YCF/FC660C-Alt-Controller/652F30B80E1377E0EDB15F7A12F2B2C8.png

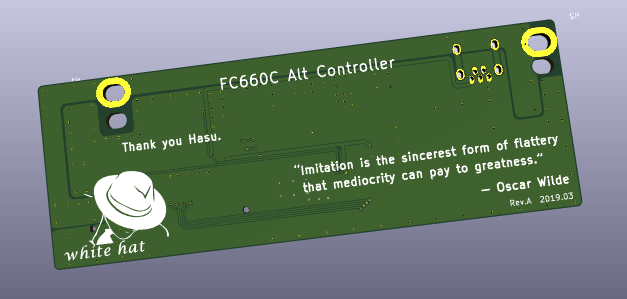
652F30B80E1377E0EDB15F7A12F2B2C8.png
