YCF/FC660C-Alt-Controller/F120661238BAEC37F7B5C9E4A22C532F.png

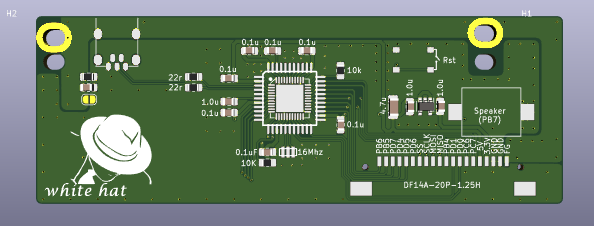
F120661238BAEC37F7B5C9E4A22C532F.png
