YCF/FC660C-Alt-Controller/dxf/edge.dxf

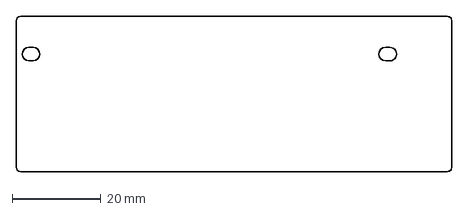
[picture p3: CAD file, 2019-03-09]
dxf/edge.dxf
98.3 x 35.0 mm
