YCF/FC660C-Alt-Controller/dxf/dwg.dxf

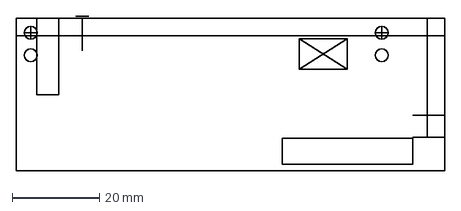
[picture p4: CAD file, 2019-03-09]
dxf/dwg.dxf
98.3 x 35.5 mm
