YCF/FC660C-Alt-Controller/kicad/fc660c/fc660c.kicad_pcb

## KiCad design kicad/fc660c/fc660c.kicad_pcb (2019-03-09)

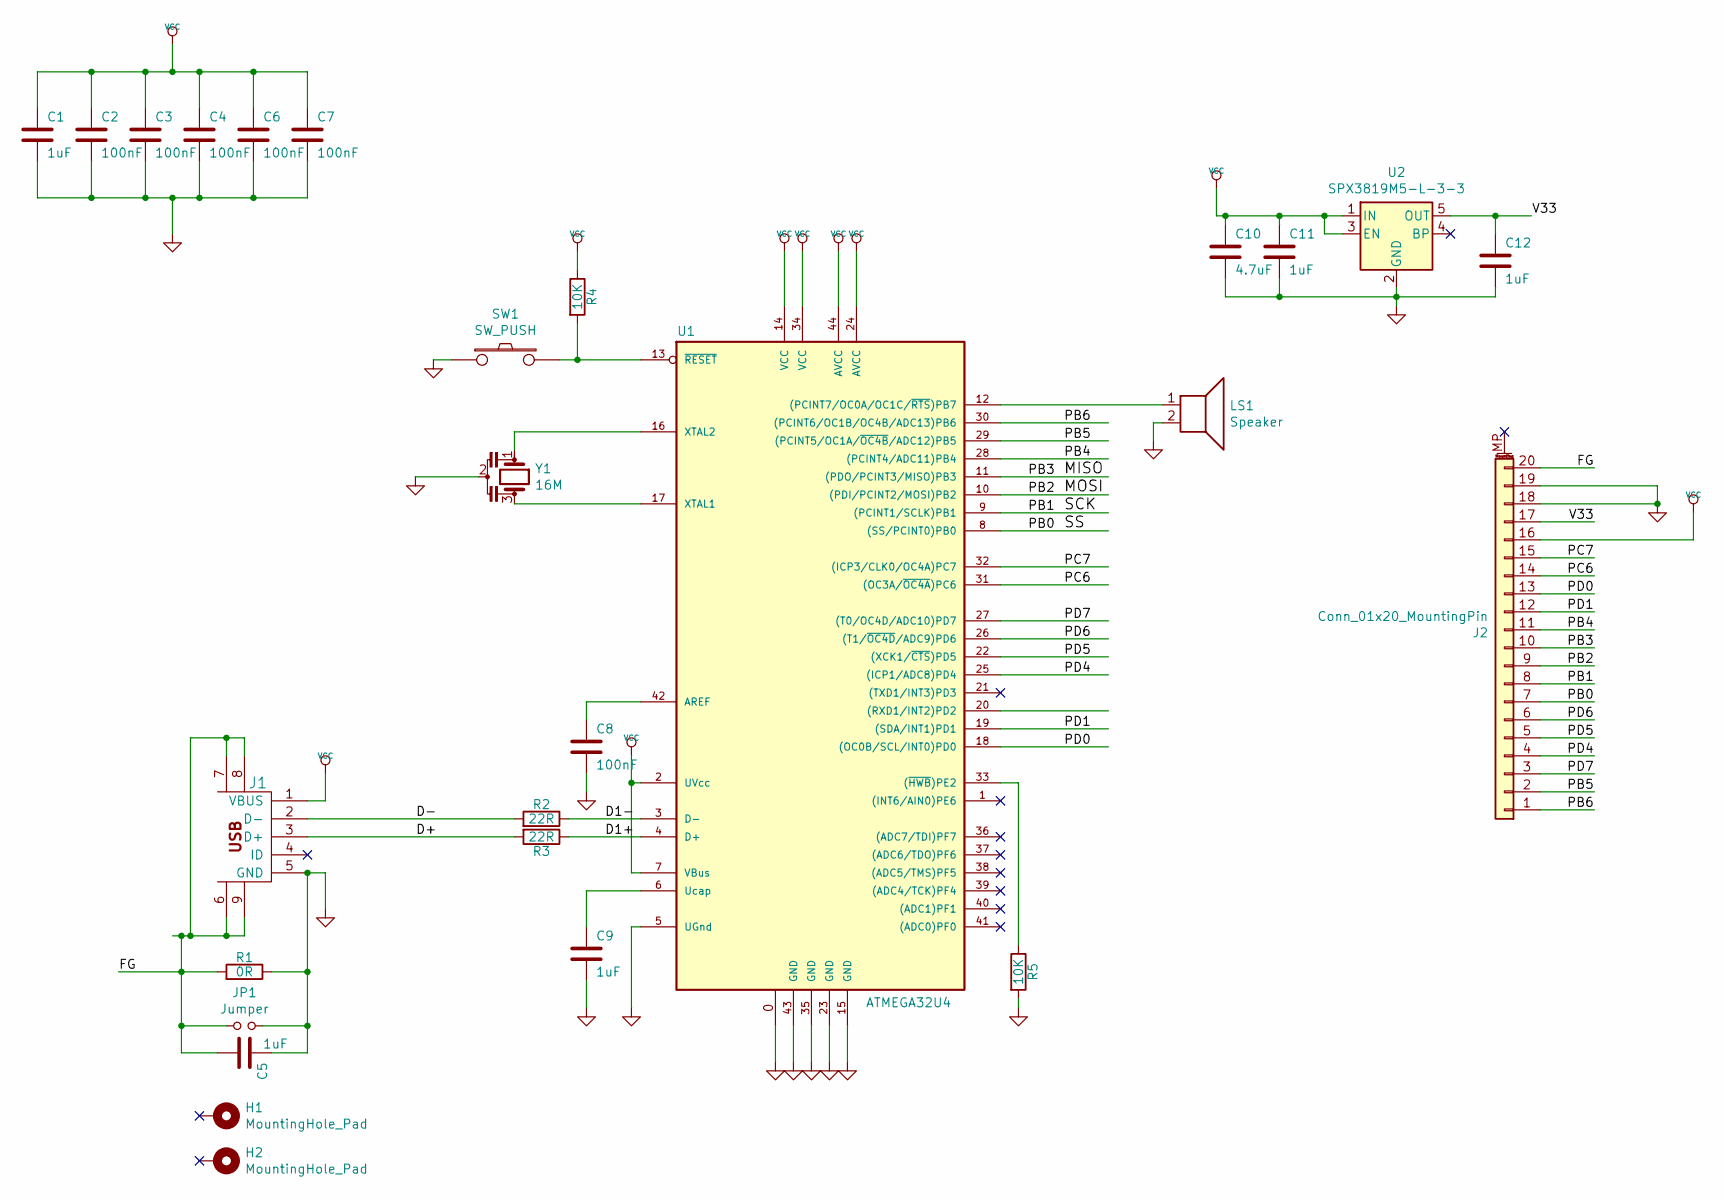
[picture p5: schematic fc660c.sch]

Parts:
C1, C5, C9, C11, C12: 1uF; C_0805_2012Metric_Pad1.15x1.40mm_HandSolder
C2, C3, C4, C6, C7, C8: 100nF; C_0805_2012Metric_Pad1.15x1.40mm_HandSolder
C10: 4.7uF; C_1206_3216Metric_Pad1.42x1.75mm_HandSolder
H1, H2: MountingHole_Pad; MountingHole_3.2_long
J1: USB_MINI-B; USB_MINI-B-marked
J2: Conn_01x20_MountingPin; HRS_DF14_20P
JP1: Jumper; SolderJumper-2_P1.3mm_Open_RoundedPad1.0x1.5mm
LS1: Speaker; SPK
R1: 0R; R_0805_2012Metric_Pad1.15x1.40mm_HandSolder
R2, R3: 22R; R_0805_2012Metric_Pad1.15x1.40mm_HandSolder
R4, R5: 10K; R_0805_2012Metric_Pad1.15x1.40mm_HandSolder
SW1: SW_PUSH; SW_Rest
U1: ATMEGA32U4; TQFP44+QFN44
U2: SPX3819M5-L-3-3; SOT-23-5
Y1: 16M; murata-resonator_SMD_CSTCE16M0V53-R0

Connections:
/D1+: R3.1, U1.4 (D+)
/D1-: R2.1, U1.3 (D-)
/D+: J1.3 (D+), R3.2
/D-: J1.2 (D-), R2.2
/FG: C5.2, J1.6, J1.7, J1.8, J1.9, J2.20, JP1.1, R1.2
/MISO: J2.10, U1.11 ((PDO/PCINT3/MISO)PB3)
/MOSI: J2.9, U1.10 ((PDI/PCINT2/MOSI)PB2)
/PB0: J2.7, U1.8 ((SS/PCINT0)PB0)
/PB1: J2.8, U1.9 ((PCINT1/SCLK)PB1)
/PB4: J2.11, U1.28 ((PCINT4/ADC11)PB4)
/PB5: J2.2, U1.29 ((PCINT5/OC1A/~OC4B~/ADC12)PB5)
/PB6: J2.1, U1.30 ((PCINT6/OC1B/OC4B/ADC13)PB6)
/PC6: J2.14, U1.31 ((OC3A/~OC4A~)PC6)
/PC7: J2.15, U1.32 ((ICP3/CLK0/OC4A)PC7)
/PD0: J2.13, U1.18 ((OC0B/SCL/INT0)PD0)
/PD1: J2.12, U1.19 ((SDA/INT1)PD1)
/PD4: J2.4, U1.25 ((ICP1/ADC8)PD4)
/PD5: J2.5, U1.22 ((XCK1/~CTS~)PD5)
/PD6: J2.6, U1.26 ((T1/~OC4D~/ADC9)PD6)
/PD7: J2.3, U1.27 ((T0/OC4D/ADC10)PD7)
/V33: C12.1, J2.17, U2.5 (OUT)
GND: C1.2, C2.2, C3.2, C4.2, C5.1, C6.2, C7.2, C8.2, C9.2, C10.2, C11.2, C12.2, J1.5 (GND), J2.18, J2.19, JP1.2, LS1.2, R1.1, R5.2, SW1.1, U1.0, U1.5 (UGnd), U1.15 (GND), U1.23 (GND), U1.35 (GND), U1.43 (GND), U2.2 (GND), Y1.2
unnamed: C8.1, U1.42 (AREF)
unnamed: C9.1, U1.6 (Ucap)
unnamed: LS1.1, U1.12 ((PCINT7/OC0A/OC1C/~RTS~)PB7)
unnamed: R4.2, SW1.2, U1.13 (~RESET~)
unnamed: R5.1, U1.33 ((~HWB~)PE2)
unnamed: U1.16 (XTAL2), Y1.1
unnamed: U1.17 (XTAL1), Y1.3
VCC: C1.1, C2.1, C3.1, C4.1, C6.1, C7.1, C10.1, C11.1, J1.1 (VBUS), J2.16, R4.1, U1.2 (UVcc), U1.7 (VBus), U1.14 (VCC), U1.24 (AVCC), U1.34 (VCC), U1.44 (AVCC), U2.1 (IN), U2.3 (EN)

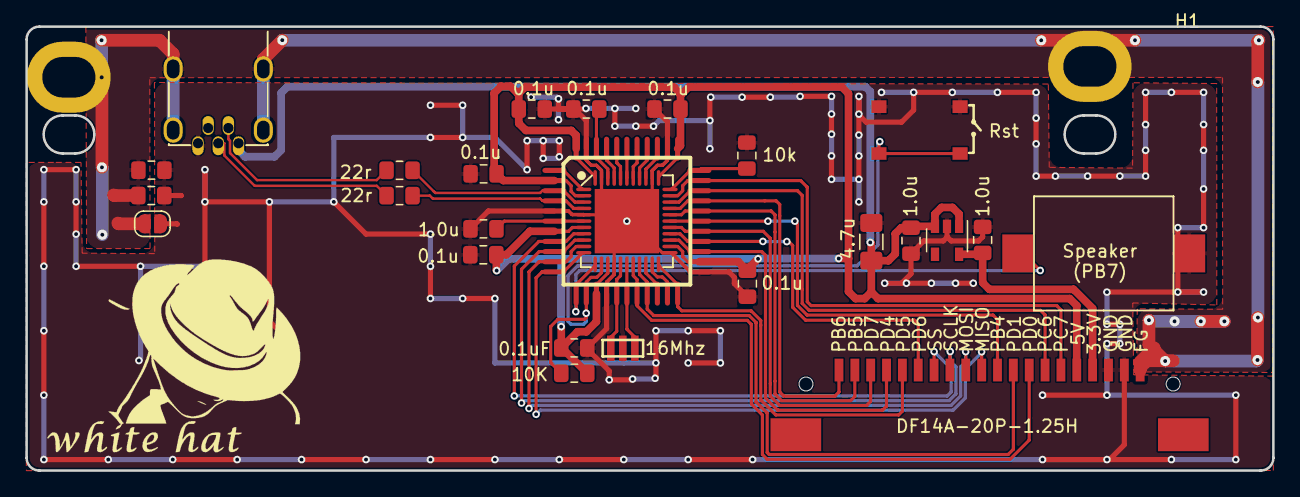
[picture p6: board fc660c.kicad_pcb from above]

Board: 2 copper layers, 98.3 x 35.0 mm, 27 parts (0 on the bottom side), 30 nets.
