YCF/FC660C-Alt-Controller/QMK/fc660c/config.h

/*
Copyright 2017 Balz Guenat

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
You should have received a copy of the GNU General Public License
along with this program.  If not, see <http://www.gnu.org/licenses/>.
*/

#ifndef CONFIG_H
#define CONFIG_H

#include "config_common.h"

/* USB Device descriptor parameter */
#define VENDOR_ID       0xFEED
#define PRODUCT_ID      0x660C
#define DEVICE_VER      0x0100
#define MANUFACTURER    QMK
#define PRODUCT         Leopold FC660C with QMK
#define DESCRIPTION     Leopold FC660C with Hasu alternative controller using QMK

/* key matrix size */
#define MATRIX_ROWS 8
#define MATRIX_COLS 16

//#define DIODE_DIRECTION

/* define if matrix has ghost */
//#define MATRIX_HAS_GHOST

/* number of backlight levels */
// #define BACKLIGHT_LEVELS  1

/* mapping backlight LEDs to correct Pin */
// #define BACKLIGHT_PIN B7

/* Set 0 if debouncing isn't needed */
#define DEBOUNCING_DELAY  0
#define TAPPING_TERM      175

/* Mechanical locking support. Use KC_LCAP, KC_LNUM or KC_LSCR instead in keymap */
// #define LOCKING_SUPPORT_ENABLE
/* Locking resynchronize hack */
// #define LOCKING_RESYNC_ENABLE

/*
 * Feature disable options
 *  These options are also useful to firmware size reduction.
 */

#define USE_I2C

/* disable debug print */
//#define NO_DEBUG

/* disable print */
//#define NO_PRINT

/* disable action features */
//#define NO_ACTION_LAYER
//#define NO_ACTION_TAPPING
//#define NO_ACTION_ONESHOT
//#define NO_ACTION_MACRO
//#define NO_ACTION_FUNCTION

// higher value means deeper actuation point, less sensitive
// be careful and only make small adjustments (steps of 1 or 2).
// too high and keys will fail to actuate. too low and keys will actuate spontaneously.
// test all keys before further adjustment.
// this should probably stay in the range +/-5.
// #define ACTUATION_DEPTH_ADJUSTMENT 0

#endif
